Leonid-98/ATMEGA1284_OLED_Gameboy/media/preview.PNG

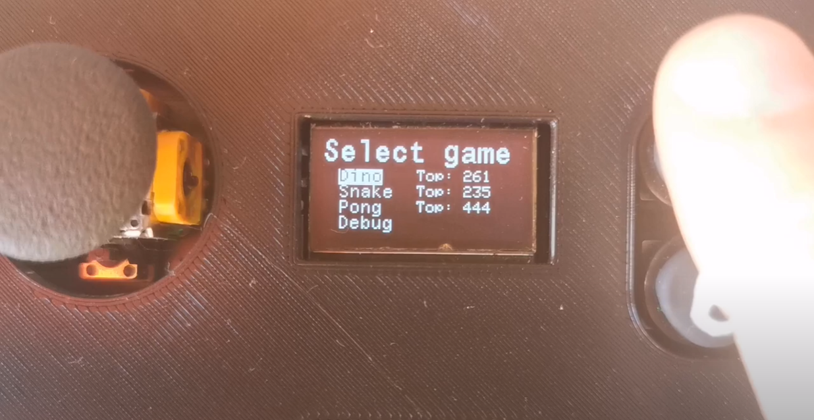
media/preview.PNG
