Leonid-98/ATMEGA1284_OLED_Gameboy/media/schematic.pdf

JTAG PROG | 9V to 5V LDO

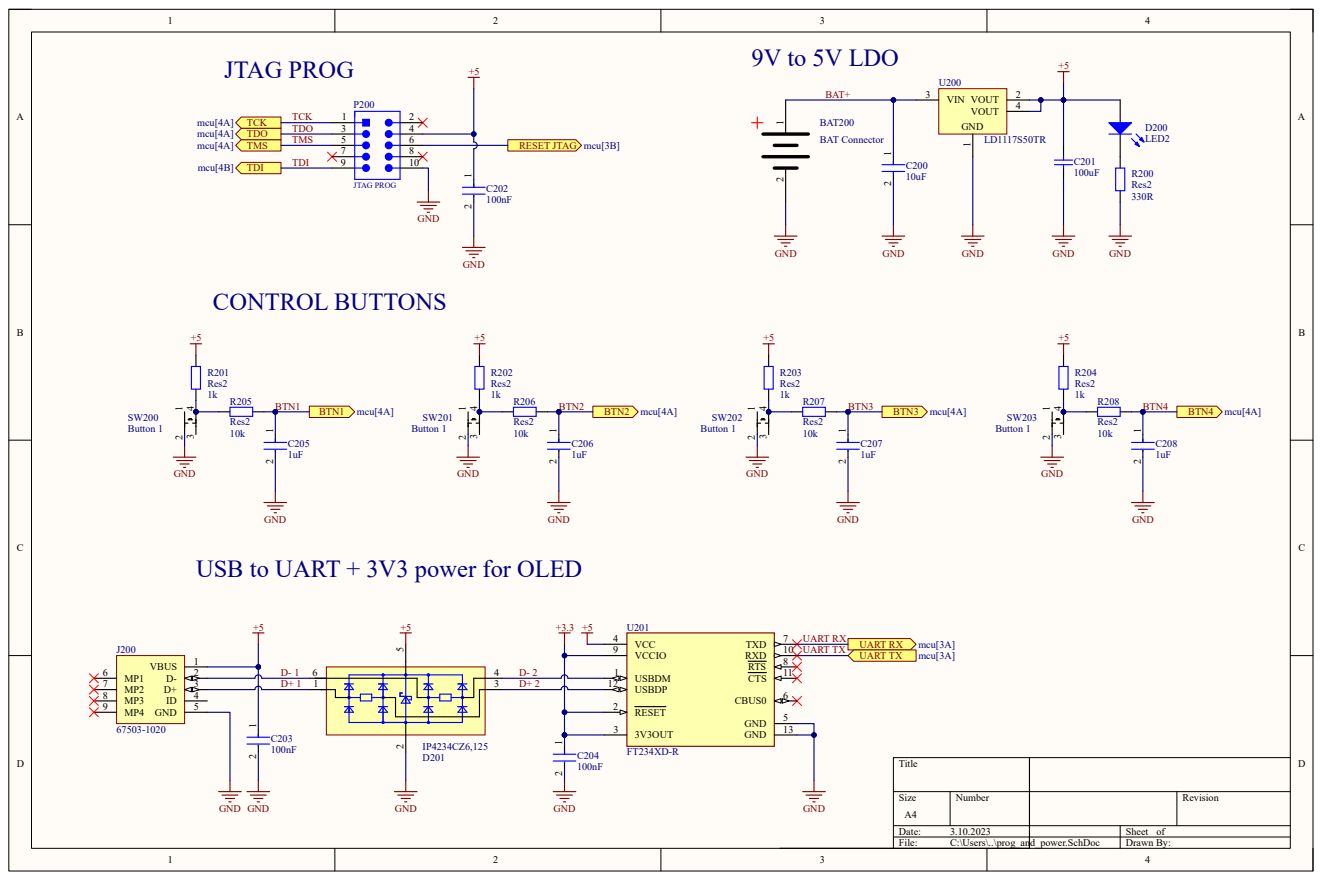
[picture p5: page 1]

GND
USB to UART + 3V3 power for OLED

A | OLED | A

# MCU

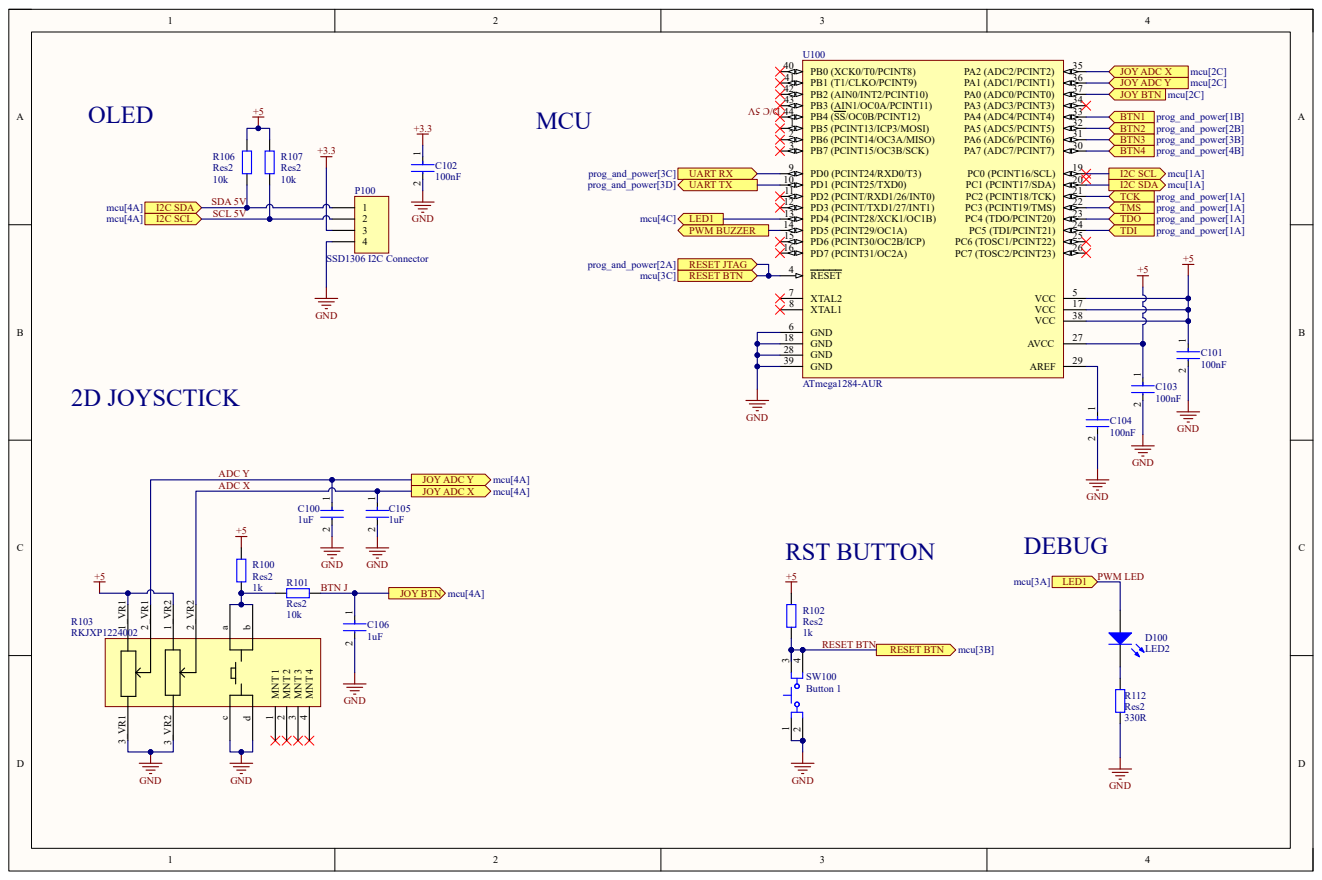
[picture p6: page 2]
