Leonid-98/ATMEGA1284_OLED_Gameboy/OLED_GameConsole/Games/Src/game.c

/*
 * game.c
 *
 * Created: 22.01.2023 3:22:14
 *  Author: msi
 */
#include <stdio.h>
#include <avr/eeprom.h>

#include "buzzer.h"
#include "button.h"
#include "ssd1306.h"
#include "game.h"

static void priv_drawMainMenu(game_selected_e selected_game);

const uint8_t game_over_bmp[] = {
	// 'game_over', 128x64px
	0x00, 0x00, 0x00, 0x00, 0x00, 0x00, 0x00, 0x00, 0x00, 0x00, 0x00, 0x00, 0x00, 0x00, 0x00, 0x00,
	0x00, 0x00, 0x1f, 0xff, 0xff, 0xff, 0xff, 0xf8, 0x1f, 0xff, 0xff, 0xff, 0xff, 0xf8, 0x00, 0x00,
	0x00, 0x00, 0x7f, 0xff, 0xff, 0xff, 0xff, 0xfc, 0x1f, 0xff, 0xff, 0xff, 0xff, 0xfc, 0x00, 0x00,
	0x00, 0x00, 0x60, 0x18, 0x03, 0x0e, 0x10, 0x04, 0x30, 0x02, 0x10, 0xc0, 0x30, 0x04, 0x00, 0x00,
	0x00, 0x00, 0xc0, 0x18, 0x03, 0x0e, 0x10, 0x04, 0x30, 0x02, 0x10, 0xc0, 0x38, 0x06, 0x00, 0x00,
	0x00, 0x00, 0xc0, 0x18, 0x03, 0x00, 0x10, 0x04, 0x30, 0x03, 0x10, 0xc0, 0x18, 0x06, 0x00, 0x00,
	0x00, 0x00, 0x87, 0xf8, 0xc7, 0x00, 0x10, 0xfc, 0x30, 0xc3, 0x10, 0xc3, 0xf8, 0x42, 0x00, 0x00,
	0x00, 0x01, 0x84, 0x18, 0x86, 0x00, 0x10, 0x04, 0x30, 0xc3, 0x08, 0xe0, 0x18, 0x43, 0x00, 0x00,
	0x00, 0x01, 0x88, 0x30, 0x86, 0x00, 0x10, 0x04, 0x30, 0xe1, 0x08, 0xe0, 0x1c, 0x03, 0x00, 0x00,
	0x00, 0x01, 0x08, 0x30, 0x06, 0x00, 0x30, 0x04, 0x30, 0xe1, 0x08, 0x60, 0x0c, 0x03, 0x00, 0x00,
	0x00, 0x03, 0x0e, 0x30, 0x06, 0x10, 0x30, 0xfc, 0x30, 0xe1, 0x08, 0x61, 0xfc, 0x21, 0x80, 0x00,
	0x00, 0x03, 0x00, 0x30, 0x06, 0x1c, 0x30, 0x0c, 0x30, 0x01, 0x08, 0x60, 0x0c, 0x21, 0x80, 0x00,
	0x00, 0x03, 0x00, 0x70, 0x8e, 0x1c, 0x30, 0x04, 0x30, 0x01, 0x80, 0xe0, 0x0c, 0x21, 0x80, 0x00,
	0x00, 0x03, 0x00, 0x61, 0x0e, 0x1c, 0x30, 0x0c, 0x30, 0x01, 0x80, 0xf0, 0x0e, 0x10, 0x80, 0x00,
	0x00, 0x03, 0x00, 0x61, 0x0c, 0x3c, 0x20, 0x0c, 0x10, 0x01, 0xc0, 0xf0, 0x06, 0x10, 0xc0, 0x00,
	0x00, 0x03, 0xff, 0xff, 0xff, 0xff, 0xff, 0xfc, 0x1f, 0xff, 0xff, 0xff, 0xff, 0xff, 0xc0, 0x00,
	0x00, 0x03, 0xff, 0xff, 0xff, 0xff, 0xff, 0xf8, 0x1f, 0xff, 0xff, 0xff, 0xff, 0xff, 0x80, 0x00,
	0x00, 0x00, 0x3e, 0x00, 0x00, 0x00, 0x1f, 0xc0, 0x01, 0xf8, 0x00, 0x03, 0xc0, 0x00, 0x00, 0x00,
	0x00, 0x00, 0x00, 0x00, 0x00, 0x00, 0x00, 0x00, 0x00, 0x00, 0x00, 0x00, 0x00, 0x00, 0x00, 0x00,
	0x00, 0x00, 0x00, 0x00, 0x00, 0x00, 0x00, 0x00, 0x00, 0x00, 0x00, 0x00, 0x00, 0x00, 0x00, 0x00,
	0x00, 0x00, 0x00, 0x00, 0x00, 0x00, 0x00, 0x00, 0x00, 0x00, 0x00, 0x00, 0x00, 0x00, 0x00, 0x00,
	0x00, 0x00, 0x00, 0x00, 0x00, 0x00, 0x00, 0x00, 0x00, 0x00, 0x00, 0x00, 0x00, 0x00, 0x00, 0x00,
	0x00, 0x00, 0x00, 0x00, 0x00, 0x00, 0x00, 0x00, 0x00, 0x00, 0x00, 0x00, 0x00, 0x00, 0x00, 0x00,
	0x00, 0x00, 0x00, 0x00, 0x00, 0x00, 0x00, 0x00, 0x00, 0x00, 0x00, 0x00, 0x00, 0x00, 0x00, 0x00,
	0x00, 0x00, 0x00, 0x00, 0x00, 0x00, 0x00, 0x00, 0x00, 0x00, 0x00, 0x00, 0x00, 0x00, 0x00, 0x00,
	0x00, 0x00, 0x00, 0x00, 0x00, 0x00, 0x00, 0x00, 0x00, 0x00, 0x00, 0x00, 0x00, 0x00, 0x00, 0x00,
	0x00, 0x00, 0x00, 0x00, 0x00, 0x00, 0x00, 0x00, 0x00, 0x00, 0x00, 0x00, 0x00, 0x00, 0x00, 0x00,
	0x00, 0x00, 0x00, 0x00, 0x00, 0x00, 0x00, 0x00, 0x00, 0x00, 0x00, 0x00, 0x00, 0x00, 0x00, 0x00,
	0x00, 0x00, 0x00, 0x00, 0x00, 0x00, 0x00, 0x00, 0x00, 0x00, 0x00, 0x00, 0x00, 0x00, 0x00, 0x00,
	0x00, 0x00, 0x00, 0x00, 0x00, 0x00, 0x00, 0x00, 0x00, 0x00, 0x00, 0x00, 0x00, 0x00, 0x00, 0x00,
	0x00, 0x00, 0x00, 0x00, 0x00, 0x00, 0x00, 0x00, 0x00, 0x00, 0x00, 0x00, 0x00, 0x00, 0x00, 0x00,
	0x00, 0x00, 0x00, 0x00, 0x00, 0x00, 0x00, 0x00, 0x00, 0x00, 0x00, 0x00, 0x00, 0x00, 0x00, 0x00,
	0x00, 0x00, 0x00, 0x00, 0x00, 0x00, 0x00, 0x00, 0x00, 0x00, 0x00, 0x00, 0x00, 0x00, 0x00, 0x00,
	0x00, 0x00, 0x00, 0x00, 0x00, 0x00, 0x00, 0x00, 0x00, 0x00, 0x00, 0x00, 0x00, 0x00, 0x00, 0x00,
	0x00, 0x00, 0x00, 0x00, 0x00, 0x00, 0x00, 0x00, 0x00, 0x00, 0x00, 0x00, 0x00, 0x00, 0x00, 0x00,
	0x1f, 0xff, 0xc0, 0x00, 0x00, 0x00, 0x00, 0x00, 0x00, 0x00, 0x00, 0x00, 0x00, 0x00, 0x7f, 0xf0,
	0x24, 0x84, 0x40, 0x00, 0x00, 0x00, 0x00, 0x00, 0x00, 0x00, 0x00, 0x00, 0x00, 0x00, 0xb4, 0x10,
	0x24, 0x9c, 0xc0, 0x00, 0x00, 0x00, 0x00, 0x00, 0x00, 0x00, 0x00, 0x00, 0x00, 0x00, 0x94, 0x90,
	0x21, 0x84, 0x20, 0x00, 0x00, 0x00, 0x00, 0x00, 0x00, 0x00, 0x00, 0x00, 0x00, 0x00, 0x86, 0xd0,
	0x33, 0x3f, 0x20, 0x00, 0x00, 0x00, 0x00, 0x00, 0x00, 0x00, 0x00, 0x00, 0x00, 0x00, 0x82, 0xc8,
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

static void priv_drawMainMenu(game_selected_e selected_game)
{
	static char buff[20];

	ssd1306_SetCursor(0, 0);
	ssd1306_WriteString("Select game:", Font_11x18, White);

	ssd1306_SetCursor(10, 20);
	ssd1306_WriteString("Dino", Font_7x10, White);
	ssd1306_SetCursor(10, 30);
	ssd1306_WriteString("Snake", Font_7x10, White);
	ssd1306_SetCursor(10, 40);
	ssd1306_WriteString("Pong", Font_7x10, White);
	ssd1306_SetCursor(10, 50);
	ssd1306_WriteString("Debug", Font_7x10, White);

	switch (selected_game)
	{
	case Game_Dino:
		ssd1306_SetCursor(10, 20);
		ssd1306_WriteString("Dino", Font_7x10, Black);
		break;
	case Game_Snake:
		ssd1306_SetCursor(10, 30);
		ssd1306_WriteString("Snake", Font_7x10, Black);
		break;
	case Game_Pong:
		ssd1306_SetCursor(10, 40);
		ssd1306_WriteString("Pong", Font_7x10, Black);
		break;
	case Game_Debug:
		ssd1306_SetCursor(10, 50);
		ssd1306_WriteString("Debug", Font_7x10, Black);
		break;
	default:
		ssd1306_SetCursor(10, 20);
		ssd1306_WriteString("Dino", Font_7x10, Black);
		break;
	}

	ssd1306_SetCursor(60, 20);
	snprintf(buff, 20, "Top: %d", game_readScore(Game_Dino));
	ssd1306_WriteString(buff, Font_6x8, White);
	buff[0] = '\0';
	ssd1306_SetCursor(60, 30);
	snprintf(buff, 20, "Top: %d", game_readScore(Game_Snake));
	ssd1306_WriteString(buff, Font_6x8, White);
	buff[0] = '\0';
	ssd1306_SetCursor(60, 40);
	snprintf(buff, 20, "Top: %d", game_readScore(Game_Pong));
	ssd1306_WriteString(buff, Font_6x8, White);
	buff[0] = '\0';
}

void game_writeScore(uint16_t new_score, game_selected_e game)
{
	switch (game)
	{
	case Game_Dino:
		eeprom_write_word(GAME_DINO_ADDR, new_score);
		break;
	case Game_Snake:
		eeprom_write_word(GAME_SNAKE_ADDR, new_score);
		break;
	case Game_Pong:
		eeprom_write_word(GAME_PONG_ADDR, new_score);
		break;
	default:
		break;
	}
}

uint16_t game_readScore(game_selected_e game)
{
	switch (game)
	{
	case Game_Dino:
		return eeprom_read_word(GAME_DINO_ADDR);
	case Game_Snake:
		return eeprom_read_word(GAME_SNAKE_ADDR);
	case Game_Pong:
		return eeprom_read_word(GAME_PONG_ADDR);
	default:
		return 1;
	}
}

void game_clearAllScores(void)
{
	eeprom_write_word(GAME_DINO_ADDR, 0);
	eeprom_write_word(GAME_SNAKE_ADDR, 0);
	eeprom_write_word(GAME_PONG_ADDR, 0);
}

bool game_over(uint16_t score, game_selected_e game)
{
	static char buff[20];
	uint8_t score_pos_x;

	ssd1306_Fill(Black);
	ssd1306_DrawBitmap(0, 0, game_over_bmp, SSD1306_WIDTH, SSD1306_HEIGHT, White);

	if (score < 10)
	{
		score_pos_x = GAME_SCORE_X0;
	}
	else if (score < 100)
	{
		score_pos_x = GAME_SCORE_X1;
	}
	else if (score < 1000)
	{
		score_pos_x = GAME_SCORE_X2;
	}
	else if (score < 10000)
	{
		score_pos_x = GAME_SCORE_X3;
	}
	else
	{
		score_pos_x = GAME_SCORE_X4;
	}

	snprintf(buff, 20, "%d", score);
	ssd1306_SetCursor(score_pos_x, GAME_SCORE_Y);
	ssd1306_WriteString(buff, Font_11x18, White);

	if (score > game_readScore(game))
	{
		game_writeScore(score, game);
	}

	ssd1306_UpdateScreen();

	buzzer_play_music();
	bool is_game_over;
	while (1)
	{
		buttons_updateAll();

		if (BUTTON_A_IS_PRESSED)
		{
			is_game_over = false;
			return is_game_over;
		}
		else if (BUTTON_B_IS_PRESSED)
		{
			is_game_over = true;
			return is_game_over;
		}
	};
}

game_selected_e game_mainMenuLoop()
{
	game_selected_e selected_game = Game_Dino;

	ssd1306_Fill(Black);
	priv_drawMainMenu(selected_game);
	ssd1306_UpdateScreen();
	while (1)
	{
		buttons_updateAll();

		if (BUTTON_DOWN_IS_PRESSED)
		{
			if (selected_game != Game_Debug) // Last game
			{
				selected_game++;
				priv_drawMainMenu(selected_game);
				ssd1306_UpdateScreen();
			}
		}

		if (BUTTON_UP_IS_PRESSED)
		{
			if (selected_game != Game_Dino) // First game
			{
				selected_game--;
				priv_drawMainMenu(selected_game);
				ssd1306_UpdateScreen();
			}
		}

		if (BUTTON_A_IS_PRESSED)
		{
			return selected_game;
		}
	}
}
