Leonid-98/ATMEGA1284_OLED_Gameboy/(commit log)

2023-01-21 Refactored timer, added debug info about TimerTick
2023-01-26 Added snake game prototype
2023-01-28 Deleted snake (bullshit code from arduino)
2023-01-29 Buzzer added defines for pins and registers
    [buzzer.c, buzzer.h]
2023-01-29 Watchdog timer test (failed)
    [main.c]
2023-03-10 Added schematic
